5haman/especcy/docs/prospectus/assets/back.png

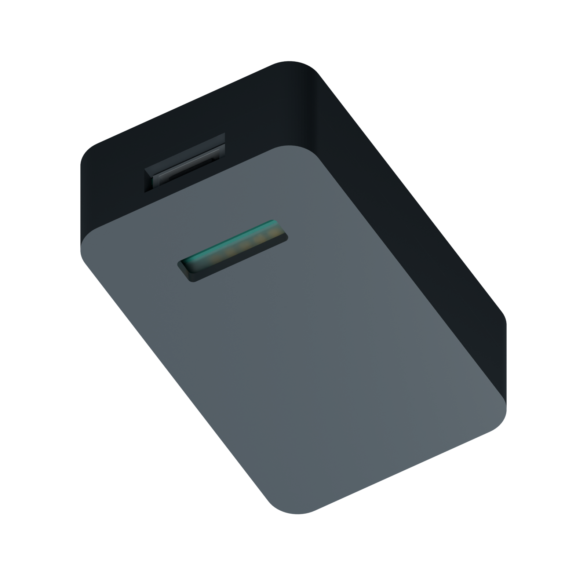
docs/prospectus/assets/back.png
