5haman/especcy/docs/prospectus/assets/exploded.png

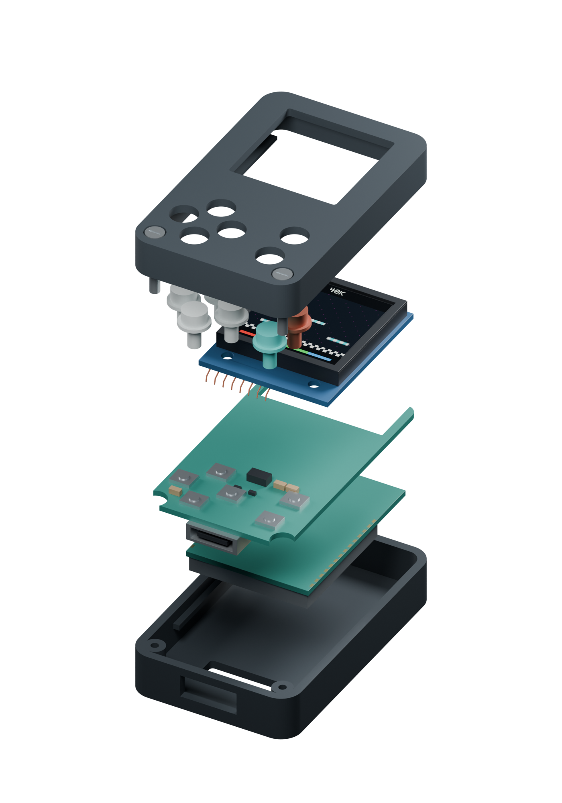
docs/prospectus/assets/exploded.png
