5haman/especcy/docs/prospectus/assets/front-photo.png

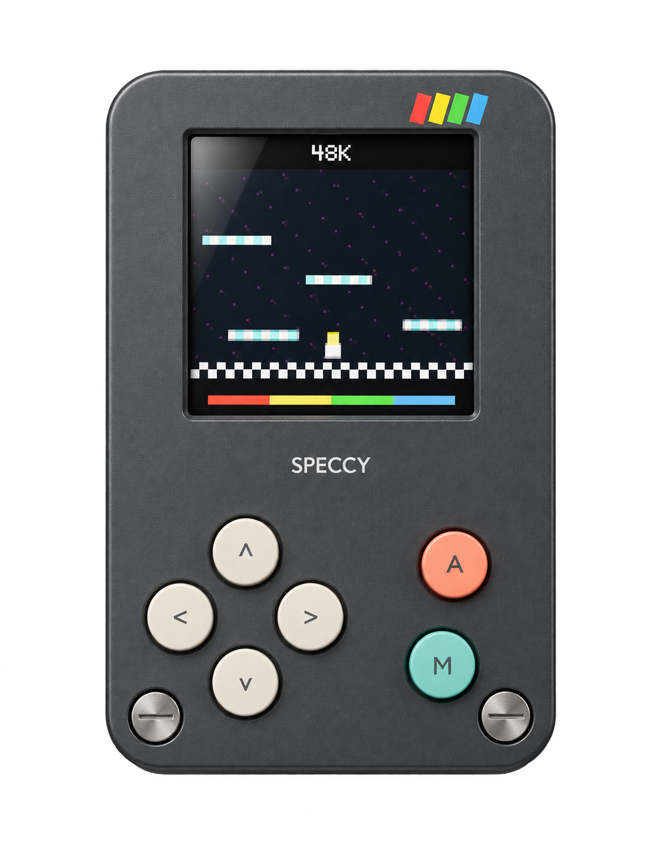
docs/prospectus/assets/front-photo.png
