5haman/especcy/docs/prospectus/assets/front.png

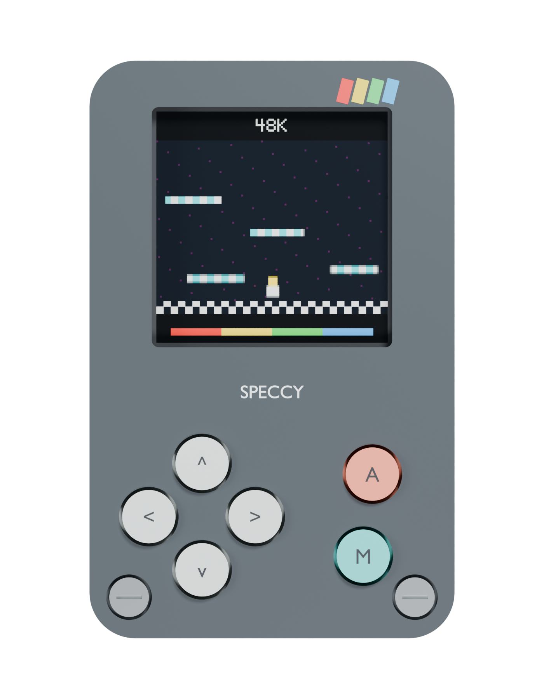
docs/prospectus/assets/front.png
