5haman/especcy/docs/prospectus/preview.jpg

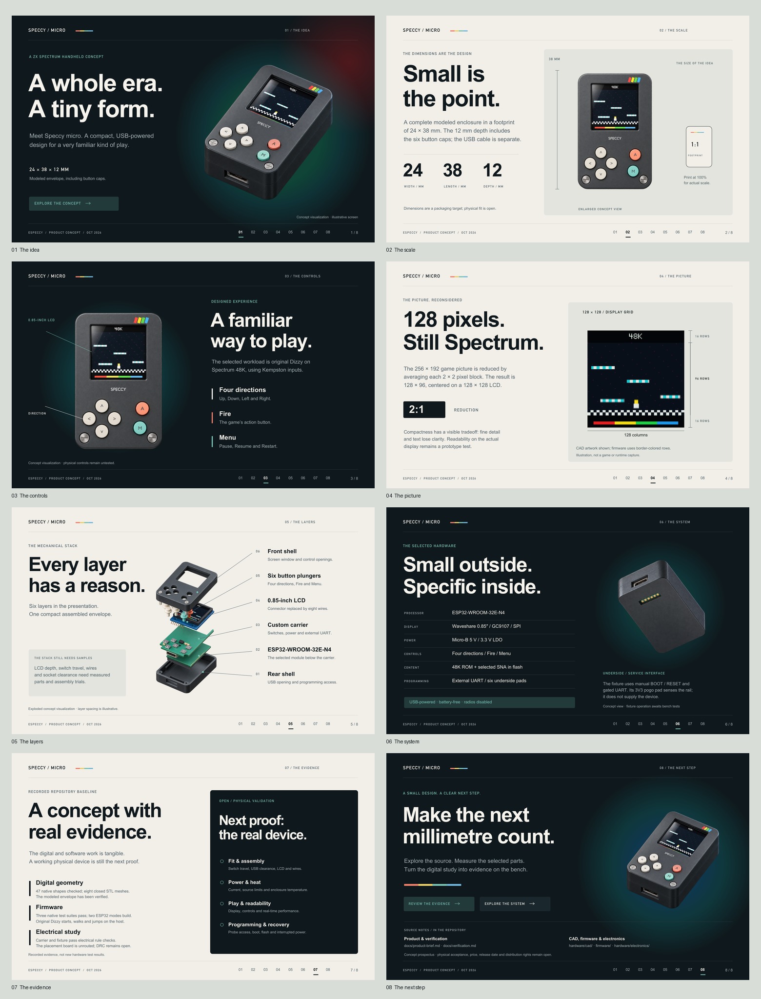
docs/prospectus/preview.jpg
