5haman/especcy/hardware/cad/renders/exploded.png

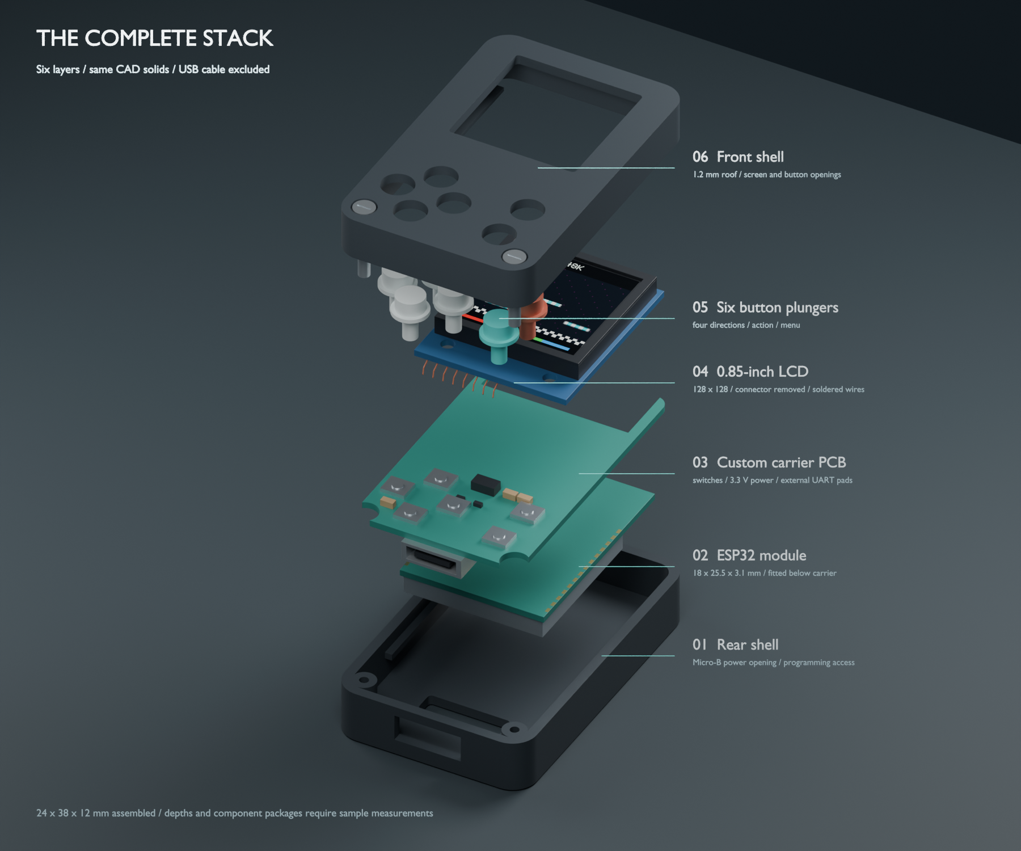
hardware/cad/renders/exploded.png
