5haman/especcy/hardware/cad/renders/programming_access.png

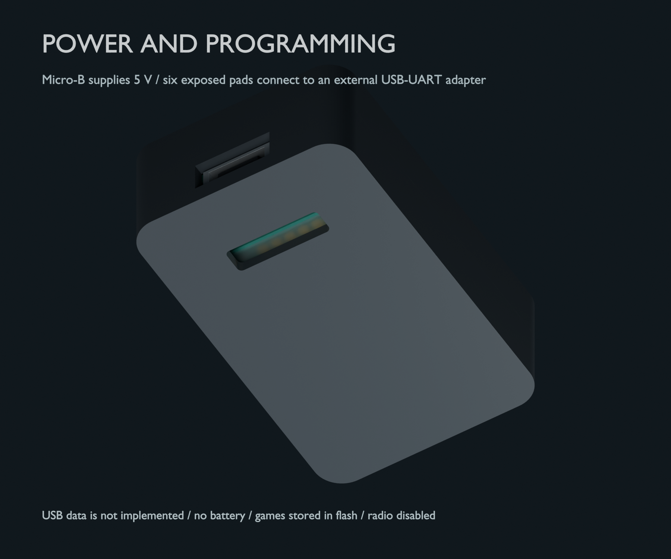
hardware/cad/renders/programming_access.png
