5haman/especcy/hardware/cad/renders/screen_128.png

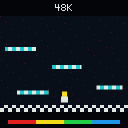
hardware/cad/renders/screen_128.png
