5haman/especcy/hardware/cad/models/speccy_micro_assembly.step

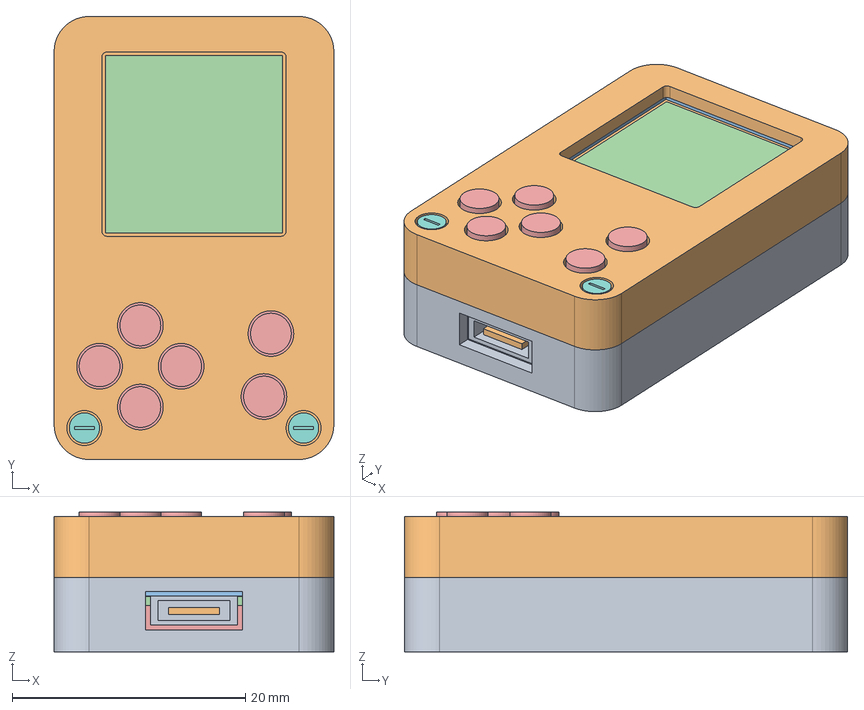
[picture p14: CAD file, 2026-10-03]
hardware/cad/models/speccy_micro_assembly.step
24.0 x 38.0 x 12.0 mm
