5haman/especcy/hardware/cad/meshes/button_menu.stl

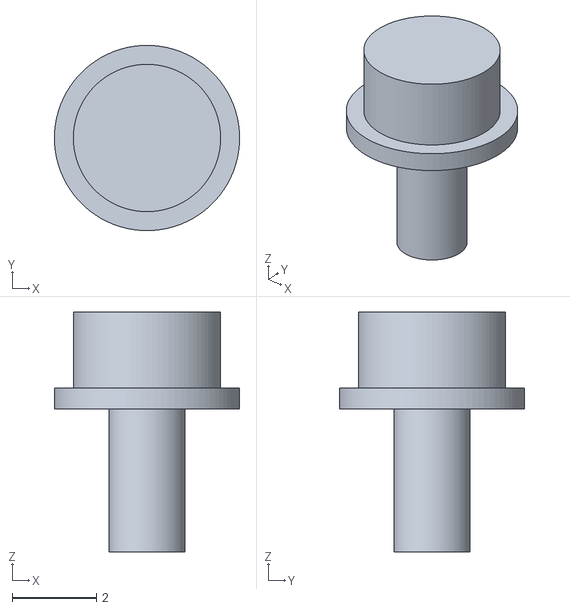
[picture p15: CAD file, 2026-10-03]
hardware/cad/meshes/button_menu.stl
4.40 x 4.40 x 5.70
