5haman/especcy/hardware/cad/models/speccy_micro.FCStd

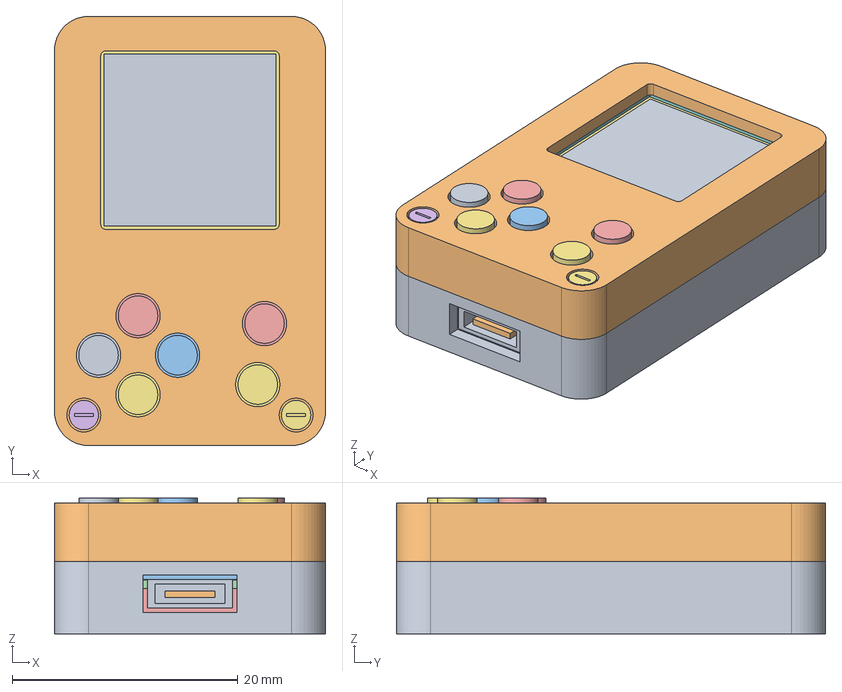
[picture p16: CAD file, 2026-10-03]
hardware/cad/models/speccy_micro.FCStd
24.0 x 38.0 x 12.0 mm
Case / Base — editable boolean shell x 2
Case / Lid — editable boolean shell x 2
Custom carrier / 20.8 × 34.8 × 0.8
ESP32-WROOM-32E / sourced 18 × 25.5 × 3.1 envelope
ESP32 shield / underside
WROOM castellated contact indication
WROOM castellated contact indication001
Antenna indication / radio OFF in this packaging
Micro-B / power only / generic envelope
USB socket tongue
GND / 3V3 / TX / RX / EN / BOOT — external UART
Up tactile / generic 3 × 2.6 × 0.65
Up / captured plunger / 3.5 mm cap
Down tactile / generic 3 × 2.6 × 0.65
Down / captured plunger / 3.5 mm cap
Left tactile / generic 3 × 2.6 × 0.65
Left / captured plunger / 3.5 mm cap
Right tactile / generic 3 × 2.6 × 0.65
Right / captured plunger / 3.5 mm cap
Fire tactile / generic 3 × 2.6 × 0.65
Fire / captured plunger / 3.5 mm cap
Menu tactile / generic 3 × 2.6 × 0.65
Menu / captured plunger / 3.5 mm cap
3.3 V LDO / SOT-23-5 package envelope
0603 decoupling / generic
0603 decoupling / generic001
0603 decoupling / generic002
EN / BOOT pullup / generic 0402
EN / BOOT pullup / generic 0403
Waveshare 0.85 LCD / sourced 19 × 22.5 footprint
LCD glass/backlight / estimated 2.0 mm depth
0.3 mm adhesive foam gasket / panel retention
15.21 × 15.21 active area / 128 × 128
LCD rear component / height estimate 1.2 mm
LCD rear component / height estimate 1.2 mm001
LCD rear component / height estimate 1.2 mm002
MX1.25 removed / eight soldered interconnect pads
LCD interconnect / illustrative route
LCD interconnect / illustrative route001
LCD interconnect / illustrative route002
LCD interconnect / illustrative route003
LCD interconnect / illustrative route004
LCD interconnect / illustrative route005
LCD interconnect / illustrative route006
LCD interconnect / illustrative route007
M1.4 case screw / estimated package
M1.4 case screw / estimated package001
