5haman/especcy/hardware/electronics/models/te-switch-nominal.step

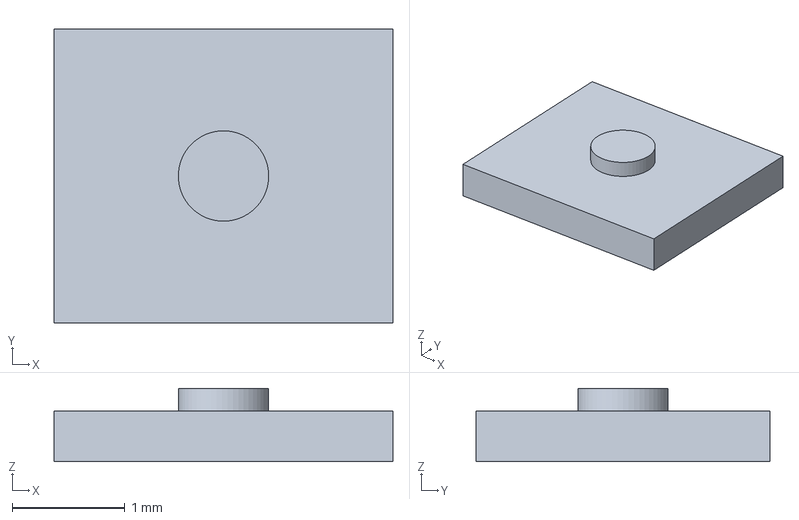
[picture p17: CAD file, 2026-10-04]
hardware/electronics/models/te-switch-nominal.step
3.00 x 2.60 x 0.65 mm
