5haman/especcy/hardware/electronics/previews/carrier.step

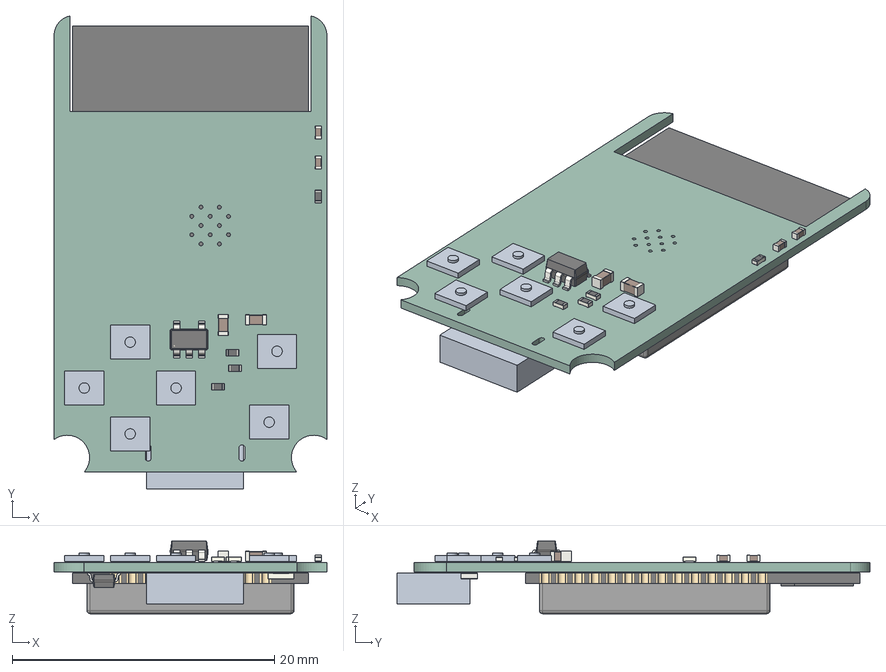
[picture p18: CAD file, 2026-10-04]
hardware/electronics/previews/carrier.step
20.8 x 36.1 x 5.53 mm
C_0603_1608Metric x 2
R_0402_1005Metric x 4
C_0402_1005Metric x 2
SOT-23-5
D_SOD-323
ESP32-WROOM-32E
Fuse_0805_2012Metric
carrier_PCB
