5haman/especcy/hardware/cad/meshes/case_lid.stl

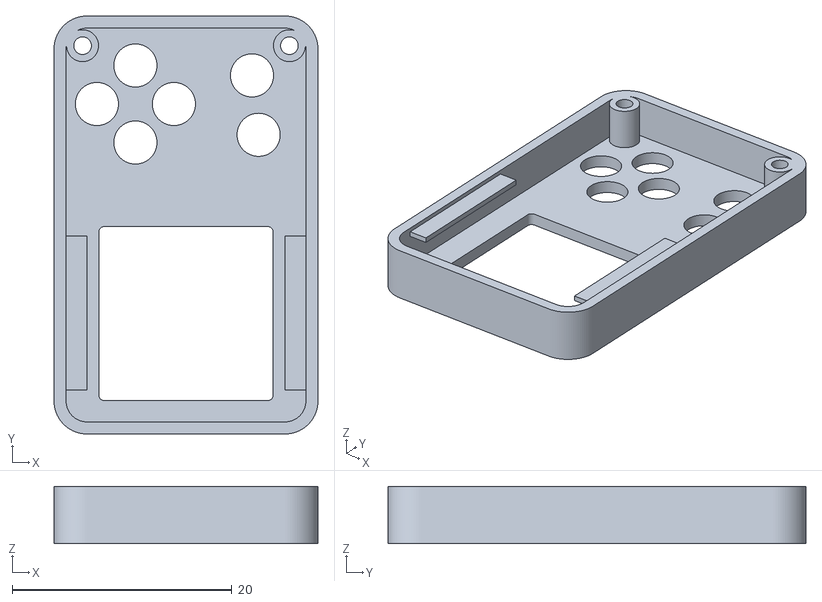
[picture p19: CAD file, 2026-10-03]
hardware/cad/meshes/case_lid.stl
24.0 x 38.0 x 5.20
