5haman/especcy/hardware/electronics/models/usb3076-nominal.step

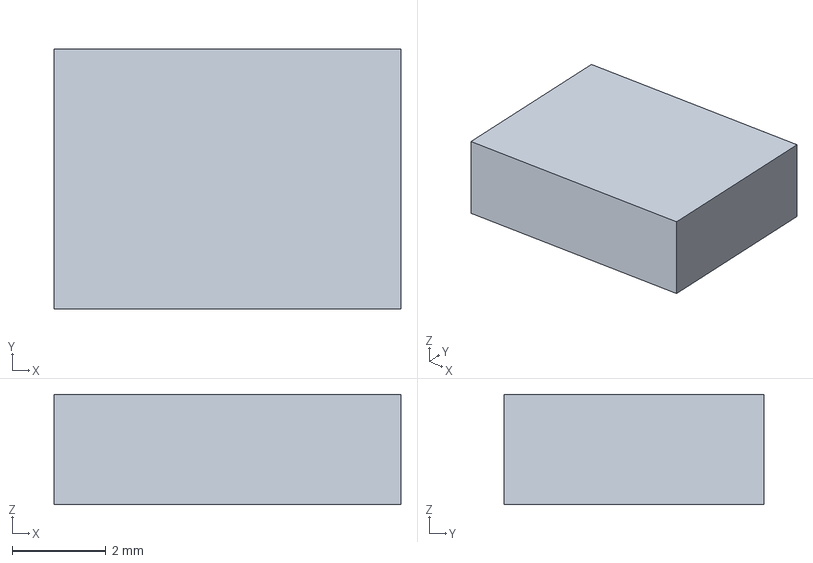
[picture p20: CAD file, 2026-10-04]
hardware/electronics/models/usb3076-nominal.step
7.40 x 5.55 x 2.35 mm
