5haman/especcy/hardware/cad/meshes/case_base.stl

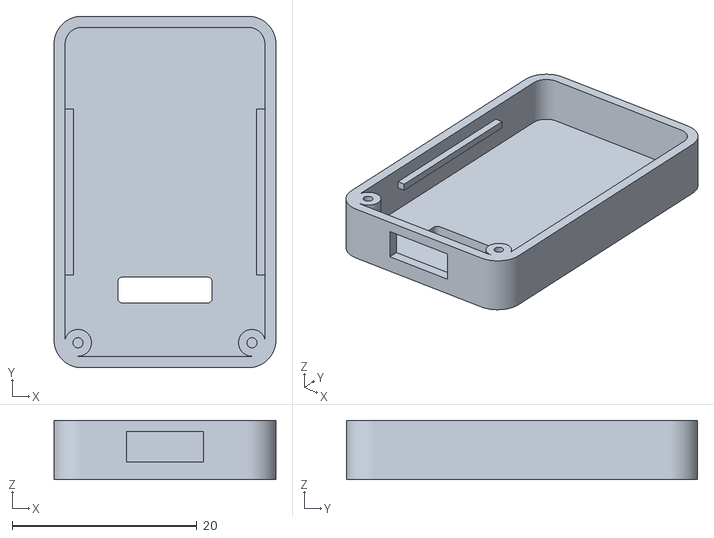
[picture p21: CAD file, 2026-10-03]
hardware/cad/meshes/case_base.stl
24.0 x 38.0 x 6.40
