5haman/especcy/(list of files, cad)

Other CAD files:
hardware/cad/meshes/button_up.stl
hardware/cad/meshes/button_left.stl
hardware/cad/meshes/button_down.stl
hardware/cad/meshes/button_fire.stl
hardware/cad/meshes/button_right.stl
hardware/cad/models/speccy_micro.blend
