5haman/especcy/hardware/cad/renders/assembled.png

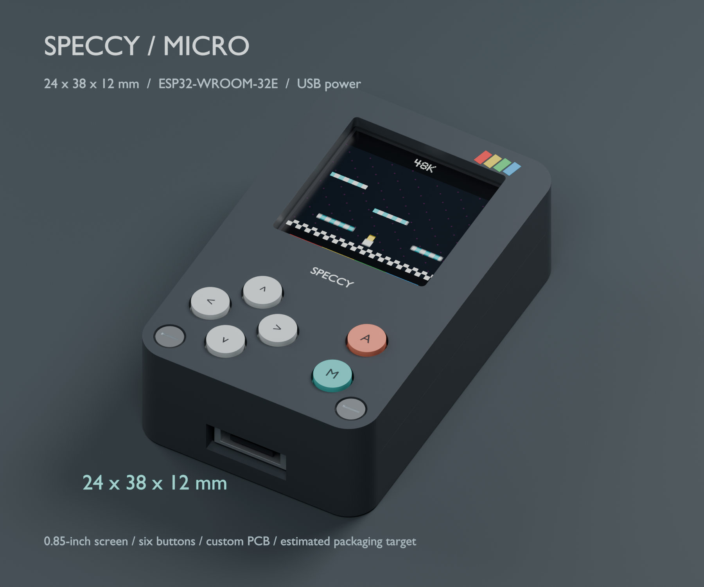
hardware/cad/renders/assembled.png
