5haman/especcy/docs/prospectus/speccy-micro-prospectus.pdf

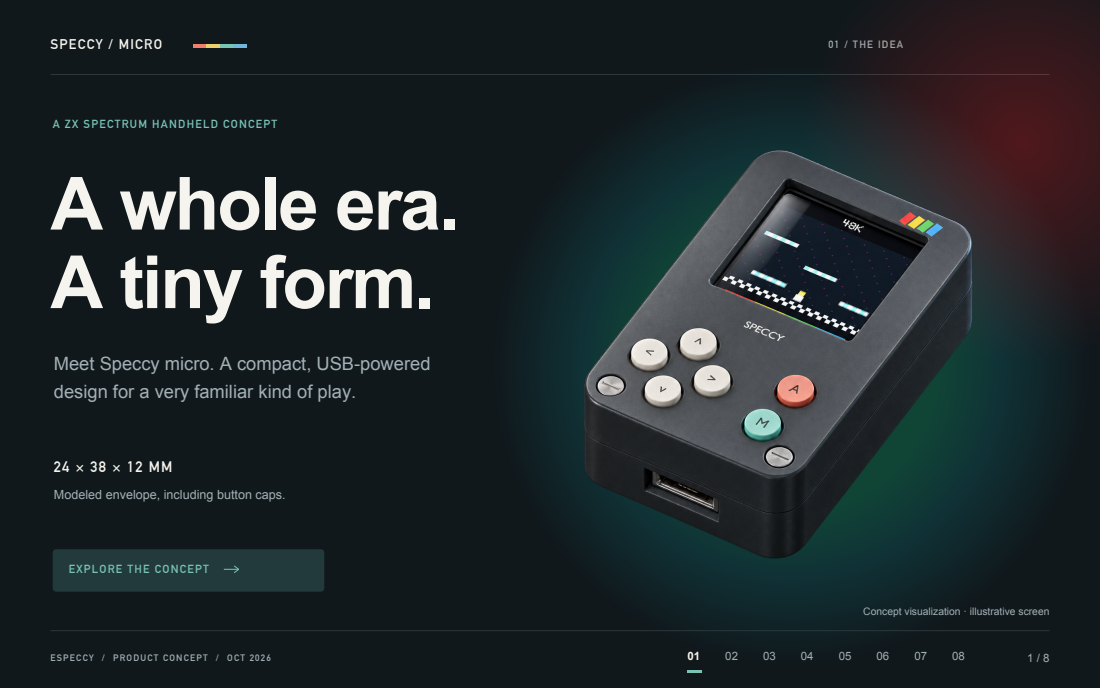
[picture p23: page 1]
SPECCY / MICRO; 01 / THE IDEA; ESPECCY / PRODUCT CONCEPT / OCT 2026

A ZX SPECTRUM HANDHELD CONCEPT
A whole era.
A tiny form.

Meet Speccy micro. A compact, USB-powered
design for a very familiar kind of play.

Modeled envelope, including button caps.

EXPLORE THE CONCEPT

Concept visualization · illustrative screen

# Small is

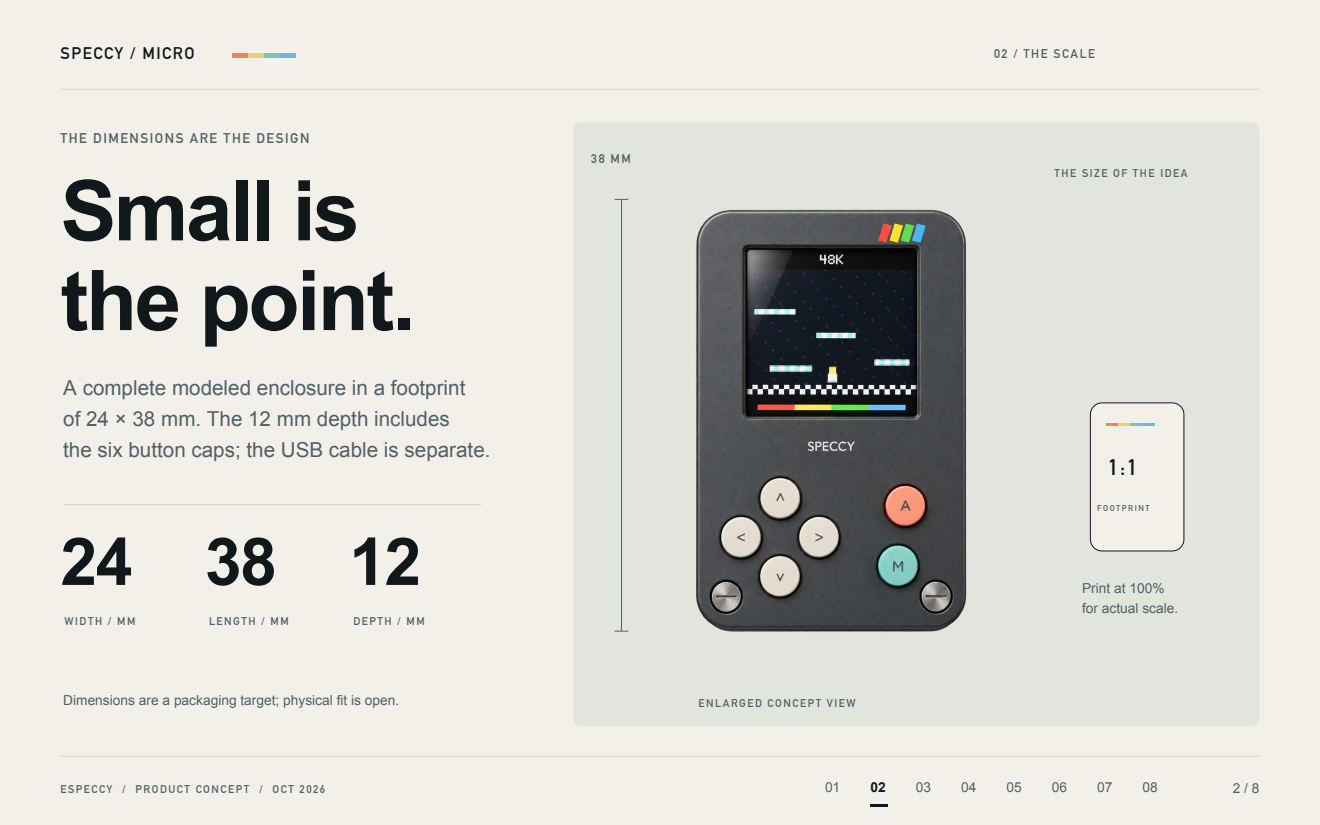
[picture p24: page 2]
SPECCY / MICRO; 02 / THE SCALE; WIDTH / MM; LENGTH / MM; DEPTH / MM; FOOTPRINT; ESPECCY / PRODUCT CONCEPT / OCT 2026

THE DIMENSIONS ARE THE DESIGN
the point.

THE SIZE OF THE IDEA

A complete modeled enclosure in a footprint
of 24 × 38 mm. The 12 mm depth includes
the six button caps; the USB cable is separate.

Print at 100%
for actual scale.

Dimensions are a packaging target; physical fit is open.

ENLARGED CONCEPT VIEW

# A familiar

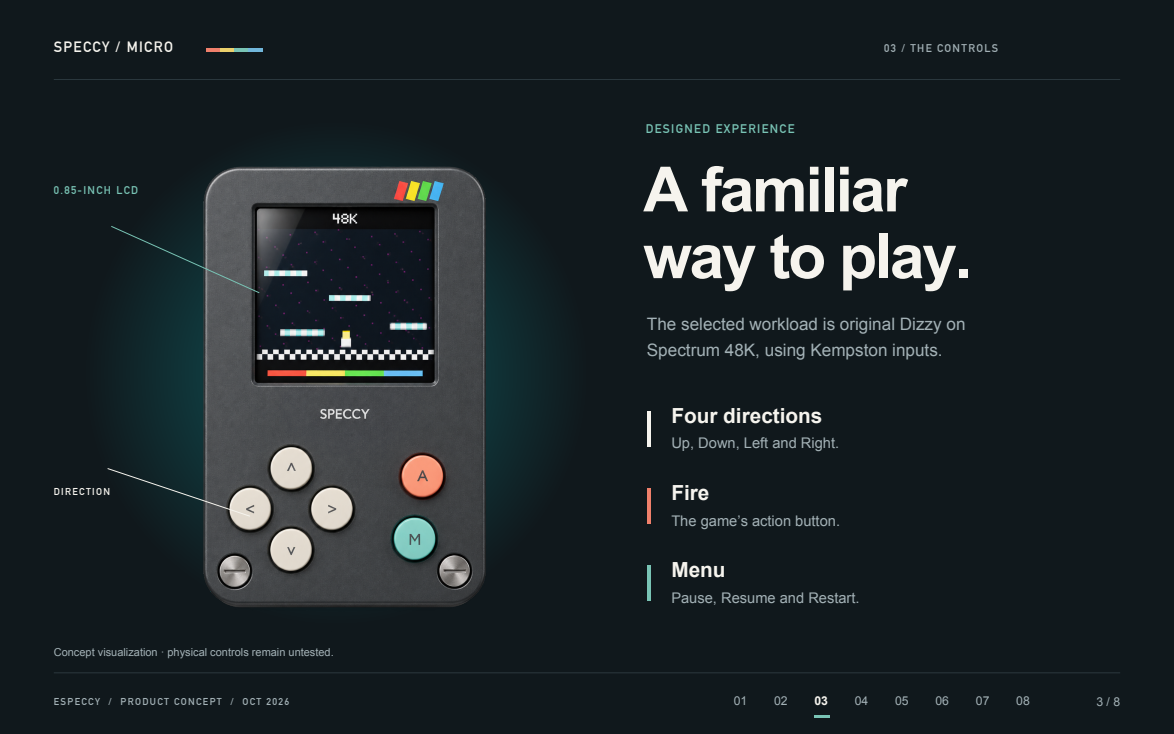
[picture p25: page 3]
SPECCY / MICRO; 03 / THE CONTROLS; 0.85-INCH LCD; DIRECTION; Four directions; Fire; Menu; ESPECCY / PRODUCT CONCEPT / OCT 2026

DESIGNED EXPERIENCE
way to play.

The selected workload is original Dizzy on
Spectrum 48K, using Kempston inputs.

Up, Down, Left and Right.

The game’s action button.

Pause, Resume and Restart.

Concept visualization · physical controls remain untested.

SPECCY / MICRO | 04 / THE PICTURE

THE PICTURE, RECONSIDERED
128 pixels.
Still Spectrum.

## The 256 × 192 game picture is reduced by

## averaging each 2 × 2 pixel block. The result is

128 × 96, centered on a 128 × 128 LCD.

2:1 | REDUCTION

Compactness has a visible tradeoff: fine detail and text lose clarity. Readability on the actual display remains a prototype test.

128 × 128 / DISPLAY GRID

### 16 ROWS

### 96 ROWS

### 16 ROWS

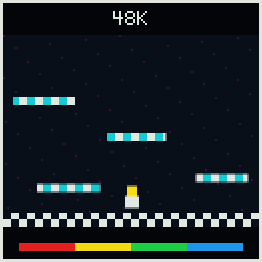
[picture p26: figure]

128 columns

CAD artwork shown; firmware uses border-colored rows.

Illustration, not a game or runtime capture.

ESPECCY / PRODUCT CONCEPT / OCT 2026 | 01 | 02 | 03 | 04 | 05 | 06 | 07 | 08 | 4 / 8

SPECCY / MICRO | 05 / THE LAYERS

THE MECHANICAL STACK

# Every layer

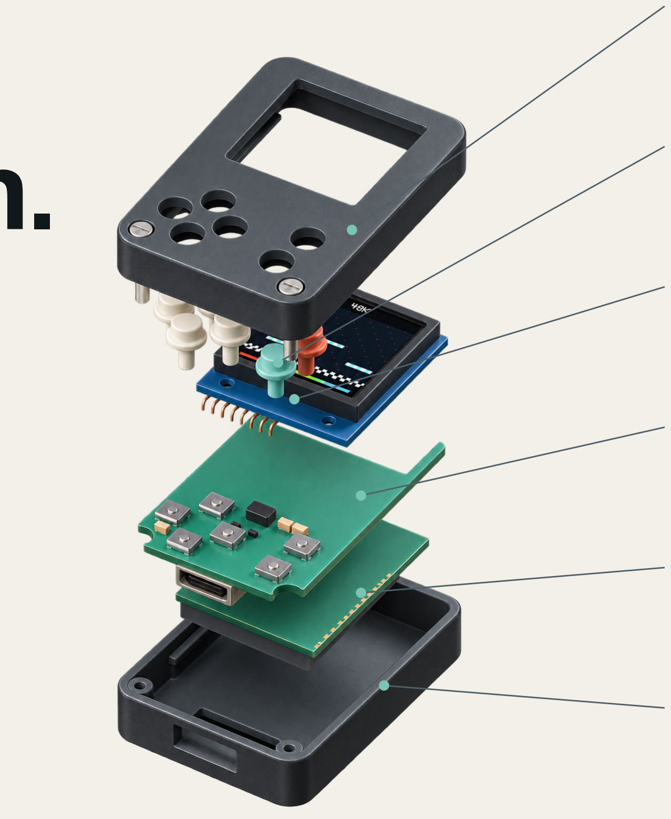
[picture p27: figure]

has a reason.

Six layers in the presentation.
One compact assembled envelope.

## 06 Front shell

Screen window and control openings.

## 05 Six button plungers

Four directions, Fire and Menu.

## 04 0.85-inch LCD

Connector replaced by eight wires.

## 03 Custom carrier

Switches, power and external UART.

## 02 ESP32-WROOM-32E-N4

The selected module below the carrier.

## 01 Rear shell

USB opening and programming access.

THE STACK STILL NEEDS SAMPLES

LCD depth, switch travel, wires
and socket clearance need measured parts and assembly trials.

Exploded concept visualization · layer spacing is illustrative.

ESPECCY / PRODUCT CONCEPT / OCT 2026 | 01 | 02 | 03 | 04 | 05 | 06 | 07 | 08 | 5 / 8

Small outside.

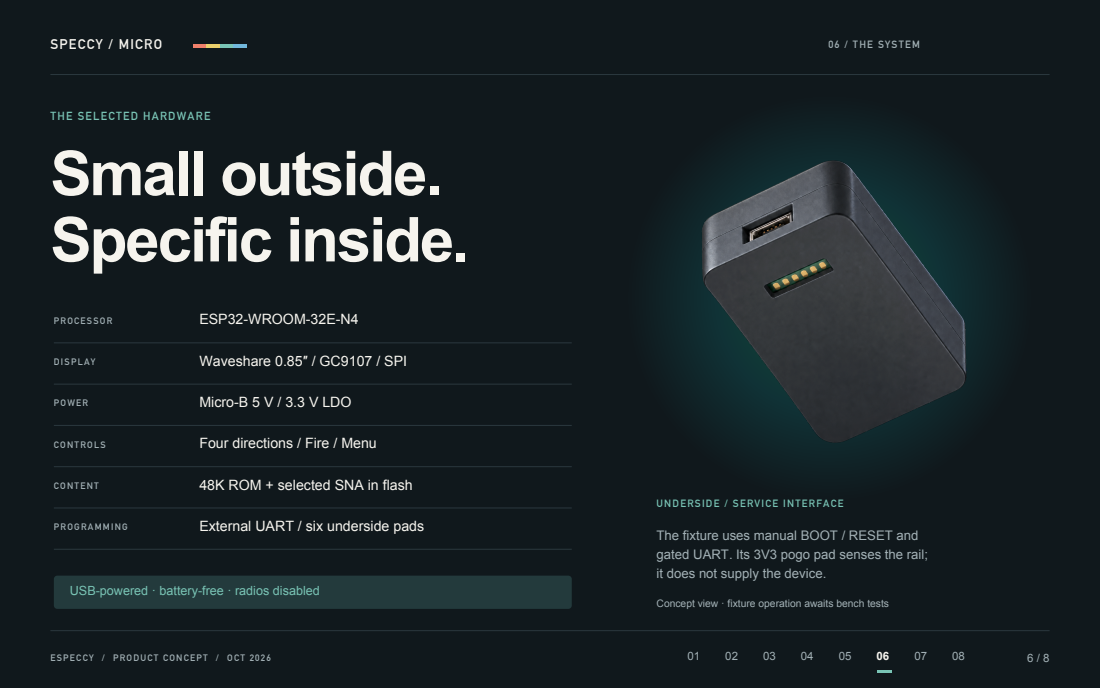
[picture p28: page 6]
SPECCY / MICRO; 06 / THE SYSTEM; PROCESSOR; ESP32-WROOM-32E-N4; DISPLAY; Waveshare 0.85″ / GC9107 / SPI; POWER; Micro-B 5 V / 3.3 V LDO; CONTROLS; Four directions / Fire / Menu; CONTENT; 48K ROM + selected SNA in flash; PROGRAMMING; External UART / six underside pads; ESPECCY / PRODUCT CONCEPT / OCT 2026

THE SELECTED HARDWARE
Specific inside.

UNDERSIDE / SERVICE INTERFACE

The fixture uses manual BOOT / RESET and
gated UART. Its 3V3 pogo pad senses the rail;
it does not supply the device.

USB-powered · battery-free · radios disabled

Concept view · fixture operation awaits bench tests

SPECCY / MICRO | 07 / THE EVIDENCE

RECORDED REPOSITORY BASELINE

# A concept with

real evidence.

The digital and software work is tangible.
A working physical device is still the next proof.

## Digital geometry

47 native shapes checked; eight closed STL meshes. The modeled envelope has been verified.

## Firmware

Three native test suites pass; two ESP32 modes build. Original Dizzy starts, walks and jumps on the host.

## Electrical study

Carrier and fixture pass electrical rule checks.
The placement board is unrouted; DRC remains open.

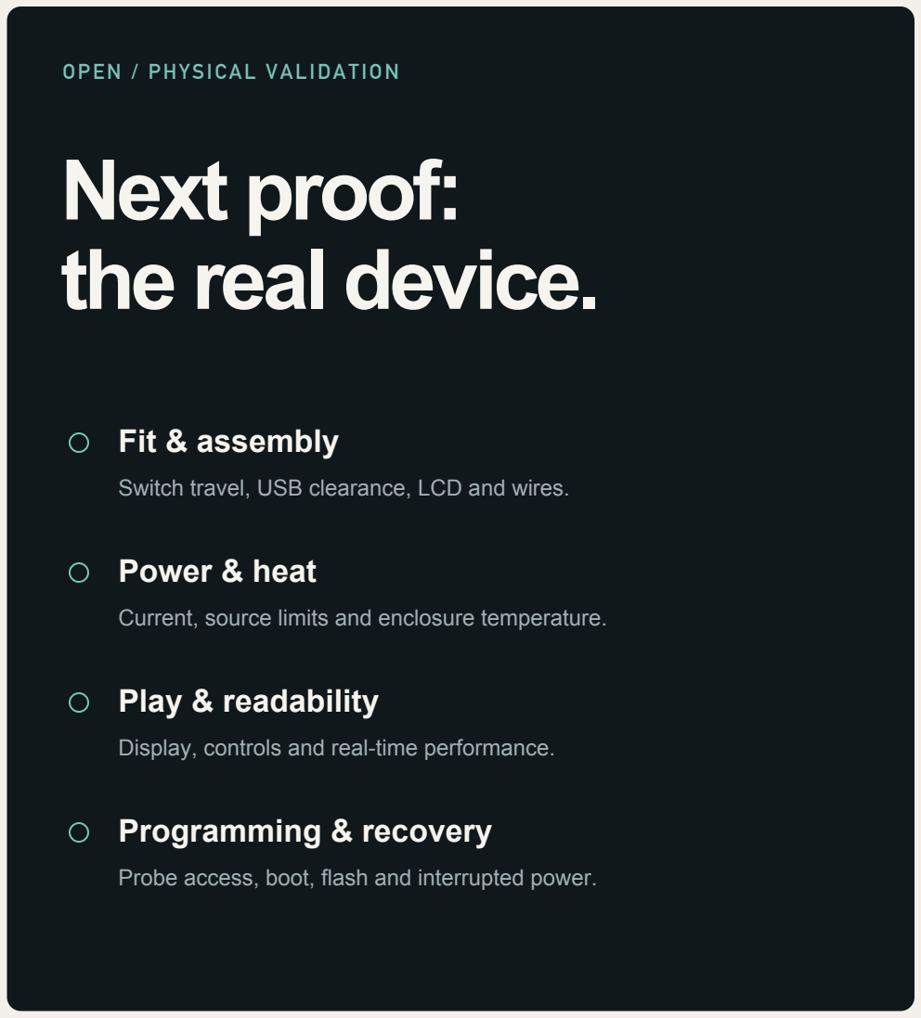
[picture p29: figure]
OPEN / PHYSICAL VALIDATION Next proof: the real device.; Fit & assembly; Power & heat; Play & readability; Display, controls and real-time performance.; Programming & recovery

Switch travel, USB clearance, LCD and wires.

Current, source limits and enclosure temperature.

Probe access, boot, flash and interrupted power.

Recorded evidence, not new hardware test results.

ESPECCY / PRODUCT CONCEPT / OCT 2026 | 01 | 02 | 03 | 04 | 05 | 06 | 07 | 08 | 7 / 8

# Make the next

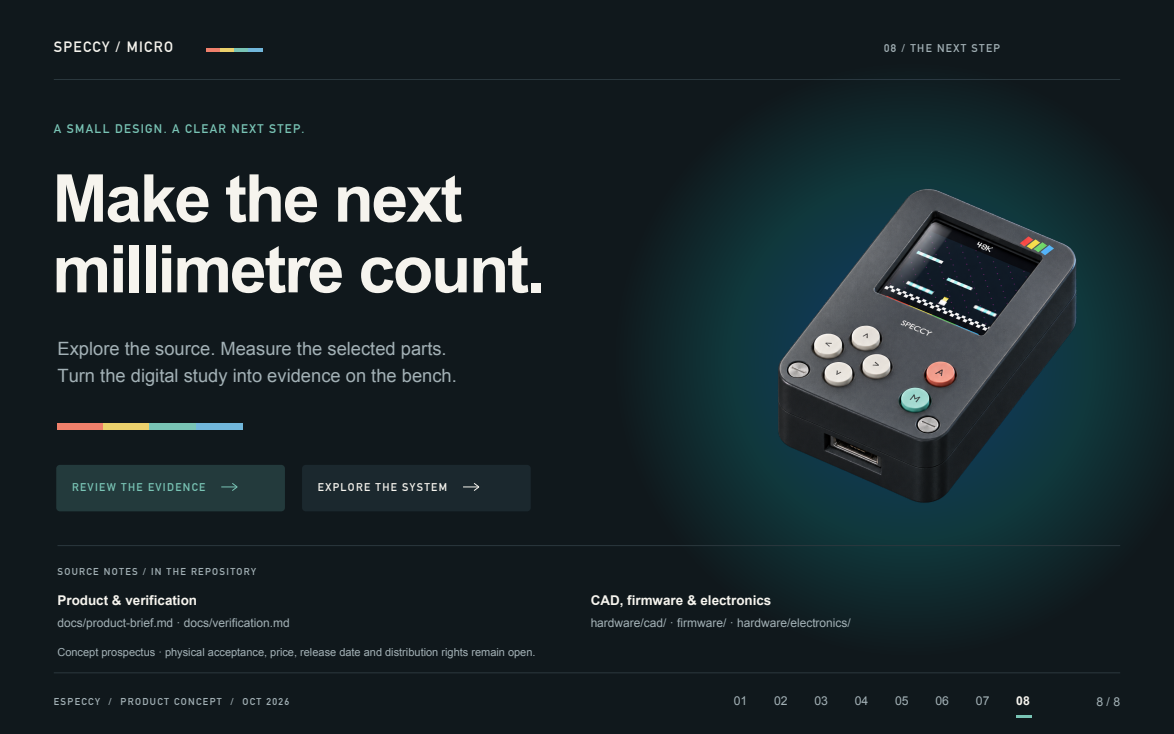
[picture p30: page 8]
SPECCY / MICRO; 08 / THE NEXT STEP; millimetre count.; REVIEW THE EVIDENCE; EXPLORE THE SYSTEM; Product & verification; ESPECCY / PRODUCT CONCEPT / OCT 2026

A SMALL DESIGN. A CLEAR NEXT STEP.

Explore the source. Measure the selected parts.
Turn the digital study into evidence on the bench.

SOURCE NOTES / IN THE REPOSITORY

CAD, firmware & electronics

docs/product-brief.md · docs/verification.md

hardware/cad/ · firmware/ · hardware/electronics/

Concept prospectus · physical acceptance, price, release date and distribution rights remain open.
