5haman/especcy/hardware/electronics/carrier.kicad_pcb

## KiCad design hardware/electronics/carrier.kicad_pcb (2026-10-04)

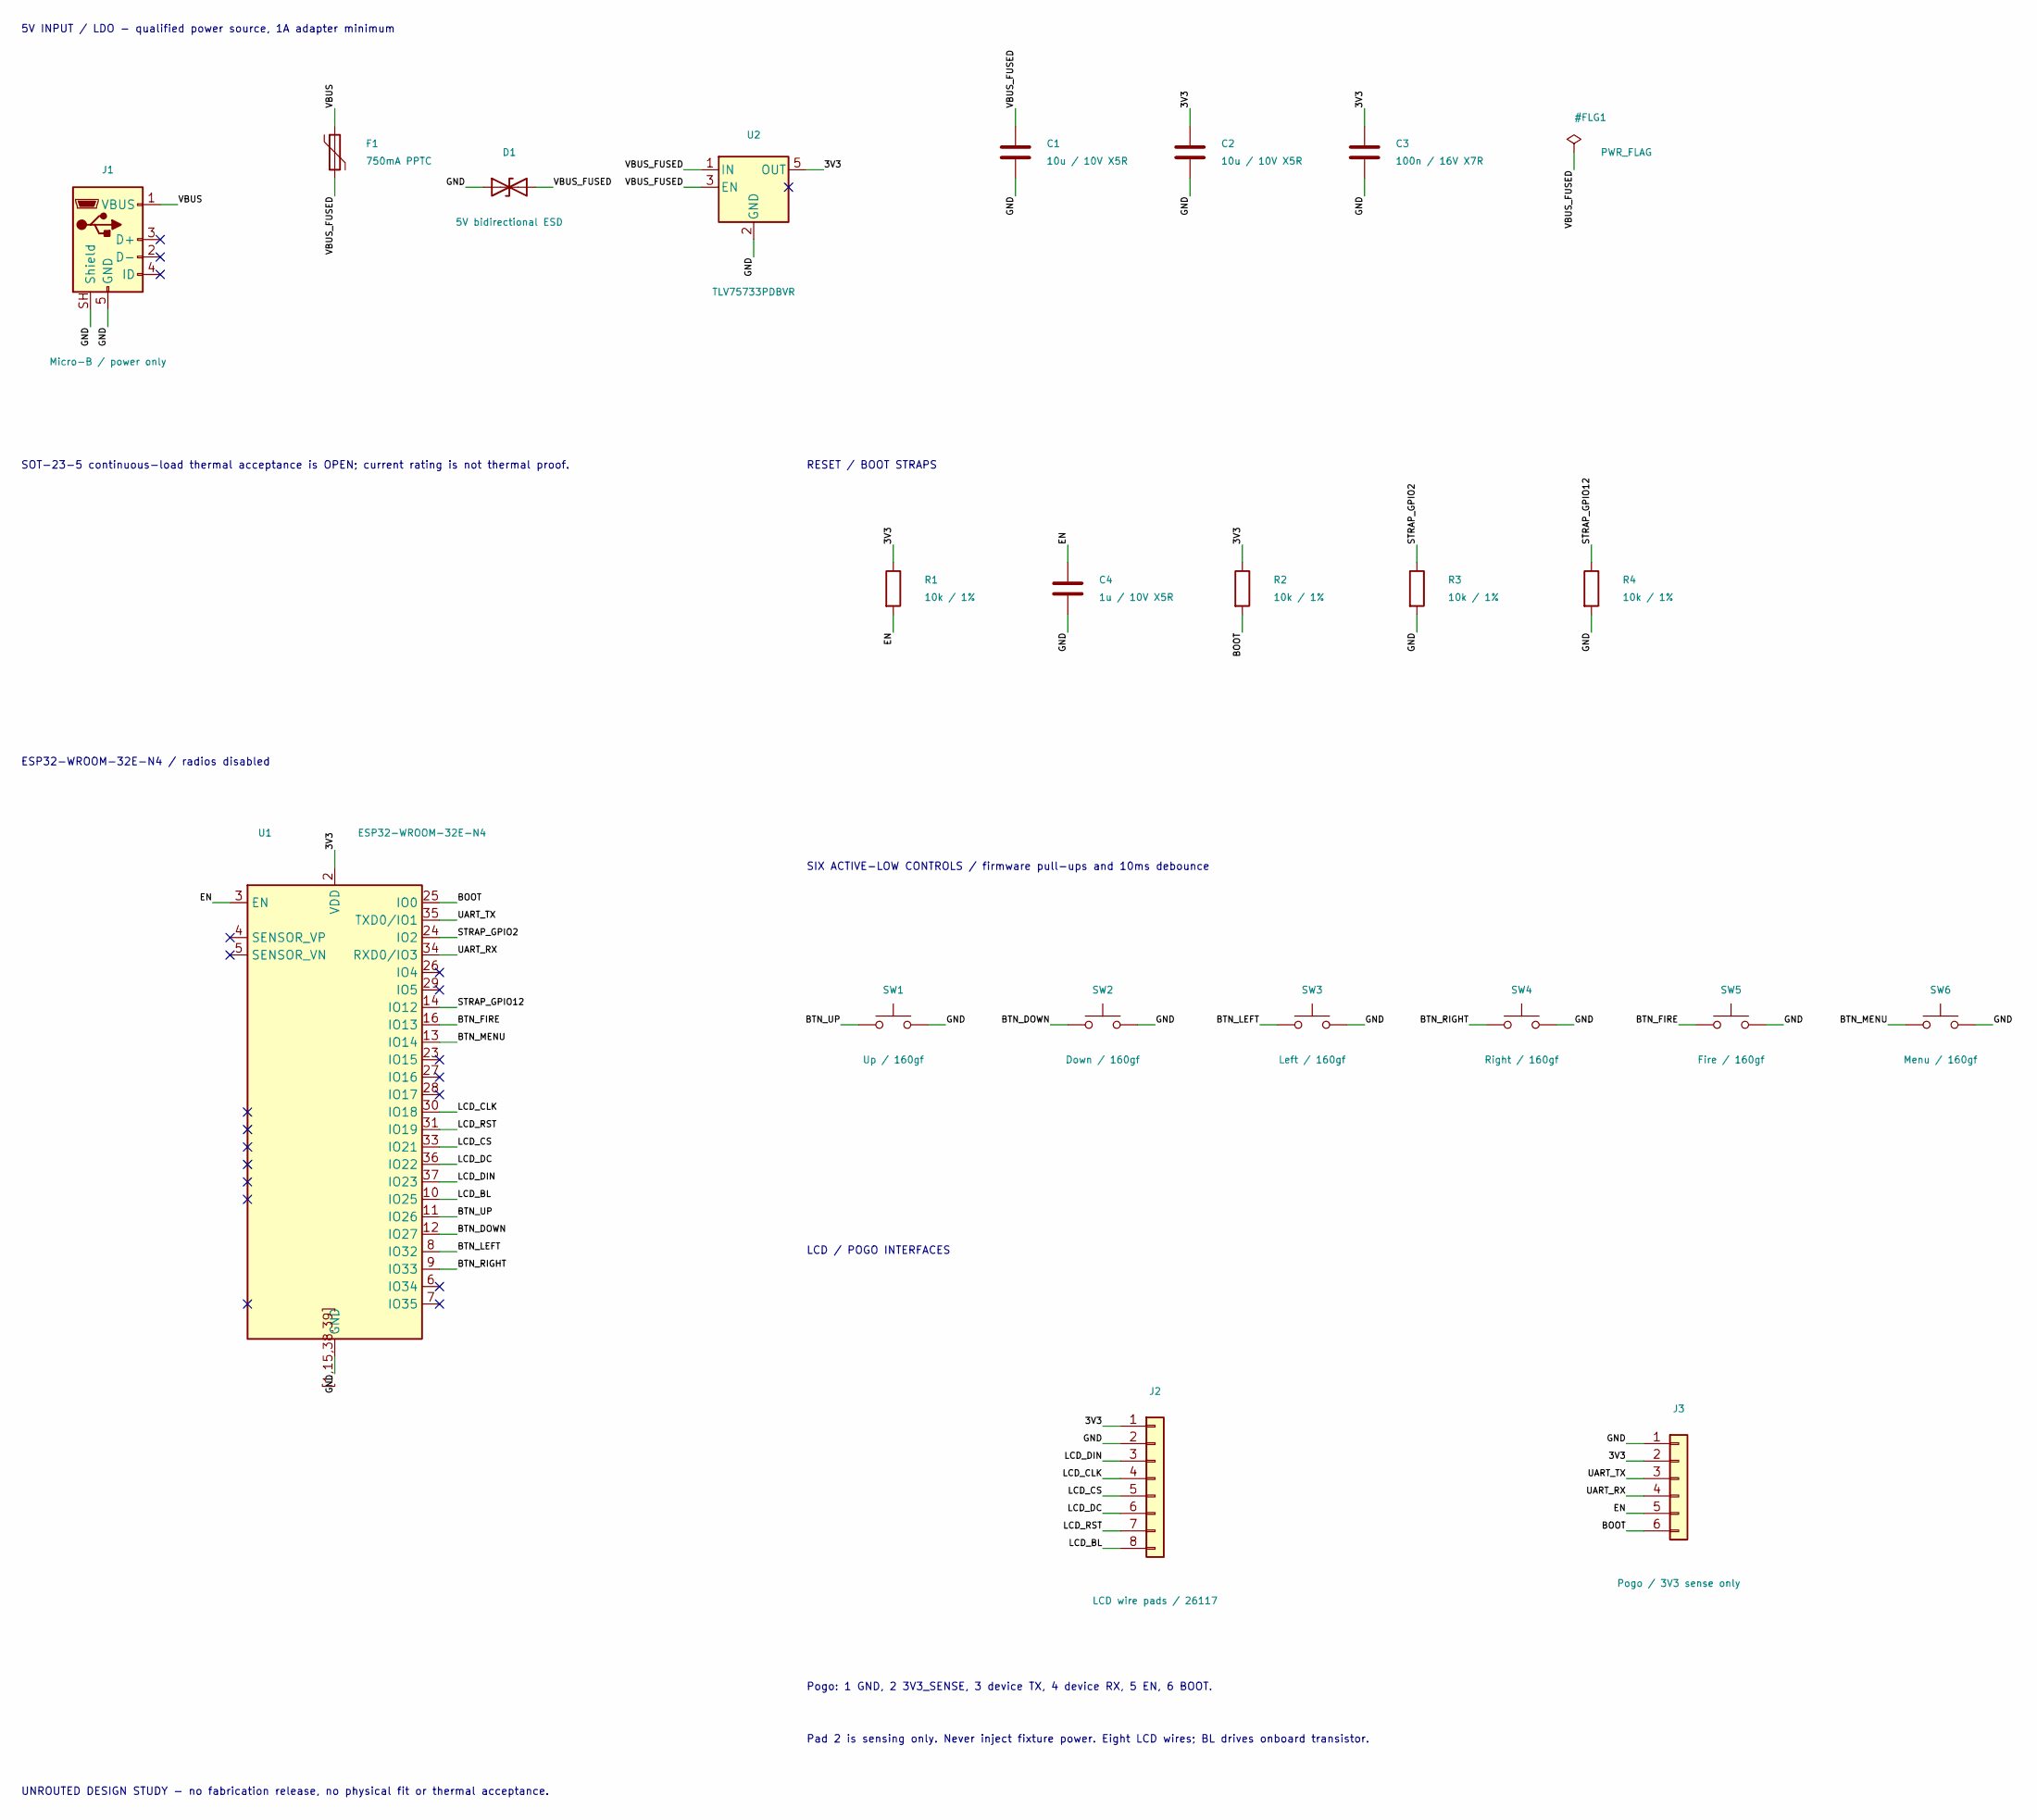
[picture p31: schematic carrier.kicad_sch, Especcy carrier - electrical and placement study]

Parts:
C1, C2: 10u / 10V X5R; C0603; MPN GRM188R61A106KE69D
C3: 100n / 16V X7R; C0402; MPN GRM155R71C104KA88D
C4: 1u / 10V X5R; C0402; MPN GRM155R61A105KE15D
D1: 5V bidirectional ESD; TVS; MPN CDSOD323-T05C
F1: 750mA PPTC; Fuse; MPN MF-PSMF075X-2
J1: Micro-B / power only; USB; MPN USB3076-30-A
J2: LCD wire pads / 26117; LCDPads; MPN PCB feature
J3: Pogo / 3V3 sense only; PogoPads; MPN PCB feature
R1, R2, R3, R4: 10k / 1%; R0402; MPN RC0402FR-0710KL
SW1: Up / 160gf; TESwitch; MPN 2337228-2
SW2: Down / 160gf; TESwitch; MPN 2337228-2
SW3: Left / 160gf; TESwitch; MPN 2337228-2
SW4: Right / 160gf; TESwitch; MPN 2337228-2
SW5: Fire / 160gf; TESwitch; MPN 2337228-2
SW6: Menu / 160gf; TESwitch; MPN 2337228-2
U1: ESP32-WROOM-32E-N4; ESP32; MPN ESP32-WROOM-32E-N4
U2: TLV75733PDBVR; SOT23_5; MPN TLV75733PDBVR

Connections:
/3V3: C2.1, C3.1, J2.1, J3.2, R1.1, R2.1, U1.2 (VDD), U2.5 (OUT)
/BOOT: J3.6, R2.2, U1.25 (IO0)
/BTN_DOWN: SW2.1, U1.12 (IO27)
/BTN_FIRE: SW5.1, U1.16 (IO13)
/BTN_LEFT: SW3.1, U1.8 (IO32)
/BTN_MENU: SW6.1, U1.13 (IO14)
/BTN_RIGHT: SW4.1, U1.9 (IO33)
/BTN_UP: SW1.1, U1.11 (IO26)
/EN: C4.1, J3.5, R1.2, U1.3 (EN)
/GND: C1.2, C2.2, C3.2, C4.2, D1.1 (A1), J1.5 (GND), J1.SH (Shield), J2.2, J3.1, R3.2, R4.2, SW1.2, SW2.2, SW3.2, SW4.2, SW5.2, SW6.2, U1.1, U1.15, U1.38, U1.39, U1.[1,15,38,39] (GND), U2.2 (GND)
/LCD_BL: J2.8, U1.10 (IO25)
/LCD_CLK: J2.4, U1.30 (IO18)
/LCD_CS: J2.5, U1.33 (IO21)
/LCD_DC: J2.6, U1.36 (IO22)
/LCD_DIN: J2.3, U1.37 (IO23)
/LCD_RST: J2.7, U1.31 (IO19)
/STRAP_GPIO2: R3.1, U1.24 (IO2)
/STRAP_GPIO12: R4.1, U1.14 (IO12)
/UART_RX: J3.4, U1.34 (RXD0/IO3)
/UART_TX: J3.3, U1.35 (TXD0/IO1)
/VBUS: F1.1, J1.1 (VBUS)
/VBUS_FUSED: C1.1, D1.2 (A2), F1.2, U2.1 (IN), U2.3 (EN)

Notes on the sheet:
5V INPUT / LDO - qualified power source, 1A adapter minimum
SOT-23-5 continuous-load thermal acceptance is OPEN; current rating is not thermal proof.
RESET / BOOT STRAPS
ESP32-WROOM-32E-N4 / radios disabled
SIX ACTIVE-LOW CONTROLS / firmware pull-ups and 10ms debounce
LCD / POGO INTERFACES
Pogo: 1 GND, 2 3V3_SENSE, 3 device TX, 4 device RX, 5 EN, 6 BOOT.
Pad 2 is sensing only. Never inject fixture power. Eight LCD wires; BL drives onboard transistor.
UNROUTED DESIGN STUDY - no fabrication release, no physical fit or thermal acceptance.

Board: 2 copper layers, 21 parts (5 on the bottom side), 22 nets, no tracks yet.
