5haman/especcy/(commit log)

2026-10-03 Add compact ESP32 handheld CAD assembly
    [button_down.stl, button_fire.stl, button_left.stl, button_menu.stl, button_right.stl, button_up.stl, case_base.stl, case_lid.stl]
2026-10-04 Add carrier electrical design and placement study
    Add editable KiCad carrier and manual fixture schematics, an unrouted placement board, exact BOMs, reproducible build checks, and generated previews. Update project documentation with verification results and remaining fit, thermal, and protection gates.
    [assembly-bom.csv, carrier-bom.csv, carrier.kicad_pcb, carrier.kicad_sch, carrier.step, fixture-bom.csv, fixture.kicad_sch, te-switch-nominal.step]
2026-10-11 Make CAD export checks and packaging reproducible
    Close review finding F-003: check_exports.py regenerates the stored
    export report byte for byte, and package.py builds a reproducible CAD
    archive in dist/ from committed files, verifying every entry.
    Remove the dead CaseBase/CaseLid collision exclusion. Those names are
    labels, not object names, so it never applied; the case halves stay in
    the pairwise check. A scratch rebuild reproduced the mechanical report,
    mesh manifest and STLs byte for byte.
2026-10-11 Add PNG export for host frames
    ppm_to_png.py converts speccy-host frames to PNG with whole-pixel
    scaling, so emulator output can be viewed on GitHub. The CLI suite
    checks the conversion pixel by pixel and rejects a truncated frame.
    Also replace two internal tags in firmware comments with plain wording.
    [main.cpp]
2026-10-11 Add CI and prepare the documentation for publication
    GitHub Actions runs the sanitizer host tests with GCC and Clang, the
    ESP-IDF v5.4.4 diagnostic build in Espressif's container, the electrical
    checks, a Markdown link checker and the CAD package build.
    Rewrite the README for a portfolio audience. Update the documentation
    suite for the U4 publication phase: resolved D-013 and F-001/F-003,
    history-rewrite note, publication verification record, and plain phase
    names in place of private tracker IDs.
2026-10-11 Shorten the README quick-start commands
    Run the host renderer from its build directory so each line fits the
    code block. The commands still reproduce docs/images/diagnostic-frame.png
    byte for byte.
