5haman/especcy/(notices)

Notices in the files:
README.md:
Software: GPL-3.0
Hardware: CERN-OHL-S-2.0
Docs: CC BY-SA 4.0
